aoe3/SprayChalkPrint/spraychalkprint.ino

//get inputted text from Serial monitor
//array of symbols linked to servo and motor directions
//iterate over textual input

#include <Stepper.h>

//create servo objects
Servo myservo1;
Servo myservo2;
Servo myservo3;
Servo myservo4;
Servo myservo5;
Servo myservo6;
Servo myservo7;

const int stepsPerRev = 200;

//create stepper objects
Stepper myStepper1(stepsPerRev, pin_coil_1, pin_coil_2, pin_coil_3, pin_coil_4);
Stepper myStepper2(stepsPerRev, pin_coil_1, pin_coil_2, pin_coil_3, pin_coil_4);

//connect pins to servos
const int servo1Pin = _;
const int servo2Pin = _;
const int servo3Pin = _;
const int servo4Pin = _;
const int servo5Pin = _;
const int servo6Pin = _;
const int servo7Pin = _;

/*//connect pins to motors -- might not happen like this
const int motor1Pin = _;
const int motor2Pin = _;*/

void setup(){
  //attach servo objects to their pins
  myservo1.attach(servo1Pin);
  myservo2.attach(servo2Pin);
  myservo3.attach(servo3Pin);
  myservo4.attach(servo4Pin);
  myservo5.attach(servo5Pin);
  myservo6.attach(servo6Pin);
  myservo7.attach(servo7Pin);

  /*//initialize motor pins as output
  pinMode(motor1Pin, OUTPUT);
  pinMode(motor2Pin, OUTPUT);*/

  myStepper1.setSpeed(30);
  myStepper2.setSpeed(30);

  // Set up serial communication
  Serial.begin(9600);
}

void loop(){
  array input;
  if(Serial.available() > 0){
    input = Serial.read();
    for(symbol in input){
      //alphabet logic
      if (symbol=="A"){
        //servo(s) trigger: 3,4,5,6,7
        myservo3.write(130);
        myservo4.write(130);
        myservo5.write(130);
        myservo6.write(130);
        myservo7.write(130);
        delay(1000);
        myservo1.write(0);
        myservo2.write(0);
        myservo3.write(0);
        myservo4.write(0);
        myservo5.write(0);
        myservo6.write(0);
        myservo7.write(0);
        //motor trigger
        myStepper1.step(stepsPerRev);
        myStepper2.step(stepsPerRev);
        //servo(s) trigger: 2,4
        myservo2.write(130);
        myservo4.write(130);
        delay(1000);
        myservo1.write(0);
        myservo2.write(0);
        myservo3.write(0);
        myservo4.write(0);
        myservo5.write(0);
        myservo6.write(0);
        myservo7.write(0);
        //motor
        myStepper1.step(stepsPerRev);
        myStepper2.step(stepsPerRev);
        //servo(s) trigger: 1,4
        myservo1.write(130);
        myservo4.write(130);
        delay(1000);
        myservo1.write(0);
        myservo2.write(0);
        myservo3.write(0);
        myservo4.write(0);
        myservo5.write(0);
        myservo6.write(0);
        myservo7.write(0);
        //motor
        myStepper1.step(stepsPerRev);
        myStepper2.step(stepsPerRev);
        //servo(s) trigger: 2,4
        myservo2.write(130);
        myservo4.write(130);
        delay(1000);
        myservo1.write(0);
        myservo2.write(0);
        myservo3.write(0);
        myservo4.write(0);
        myservo5.write(0);
        myservo6.write(0);
        myservo7.write(0);
        //motor
        myStepper1.step(stepsPerRev);
        myStepper2.step(stepsPerRev);
        //servo(s) trigger: 3,4,5,6,7
        myservo3.write(130);
        myservo4.write(130);
        myservo5.write(130);
        myservo6.write(130);
        myservo7.write(130);
        delay(1000);
        myservo1.write(0);
        myservo2.write(0);
        myservo3.write(0);
        myservo4.write(0);
        myservo5.write(0);
        myservo6.write(0);
        myservo7.write(0);
        //motor twice
        myStepper1.step(2*stepsPerRev);
        myStepper2.step(2*stepsPerRev);
      }
      else if(symbol=="B"){
        //servo(s) trigger: 1,2,3,4,5,6,7
        myservo1.write(130);
        myservo2.write(130);
        myservo3.write(130);
        myservo4.write(130);
        myservo5.write(130);
        myservo6.write(130);
        myservo7.write(130);
        delay(1000);
        myservo1.write(0);
        myservo2.write(0);
        myservo3.write(0);
        myservo4.write(0);
        myservo5.write(0);
        myservo6.write(0);
        myservo7.write(0);
        //motor trigger
        myStepper1.step(stepsPerRev);
        myStepper2.step(stepsPerRev);
        //servo(s) trigger: 1,4,7
        myservo1.write(130);
        myservo4.write(130);
        myservo7.write(130);
        delay(1000);
        myservo1.write(0);
        myservo2.write(0);
        myservo3.write(0);
        myservo4.write(0);
        myservo5.write(0);
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
        myservo3.write(0);
        myservo4.write(0);
        myservo5.write(0);
        myservo6.write(0);
        myservo7.write(0);
        //motor
        //motor
        myStepper1.step(2*stepsPerRev);
        myStepper2.step(2*stepsPerRev);
      }
      else(){}
    }
  }
}
